serickson017/TAMU-ECEN-404-Team-29-Capstone/Presentations/Automated Greenhouse Status Update 1  (1).pdf

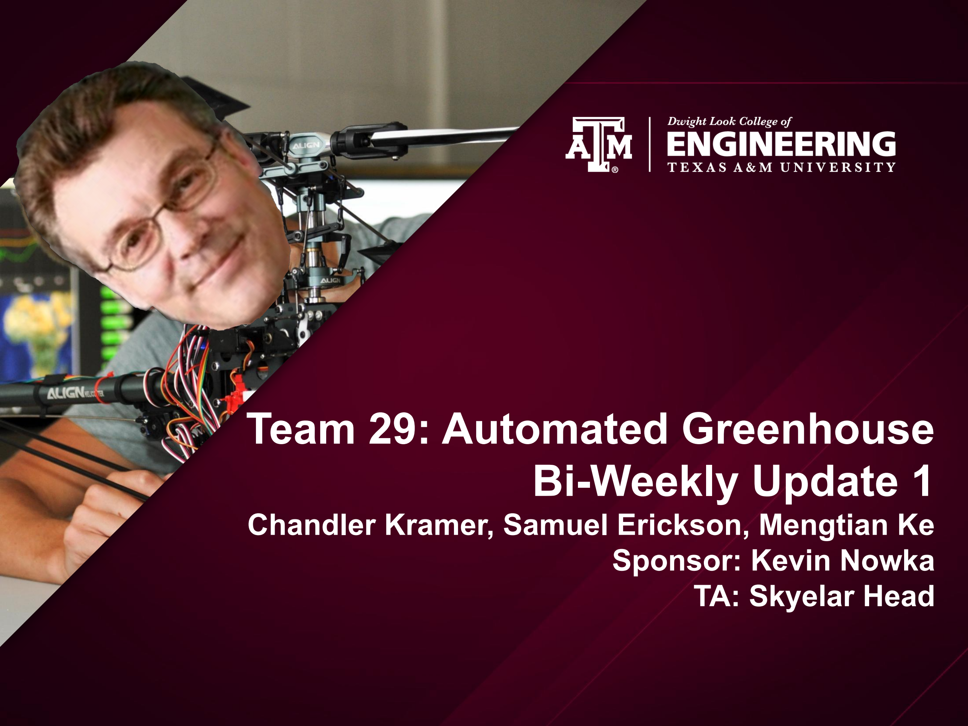
[picture p25: page 1]

# Team 29: Automated Greenhouse Bi-Weekly Update 1

### Chandler Kramer, Samuel Erickson, Mengtian Ke Sponsor: Kevin Nowka TA: Skyelar Head

# Project Summary

## - Traditional gardening, even with a greenhouse, is a very manual process that can be very time consuming and plants are still vulnerable to

the elements.

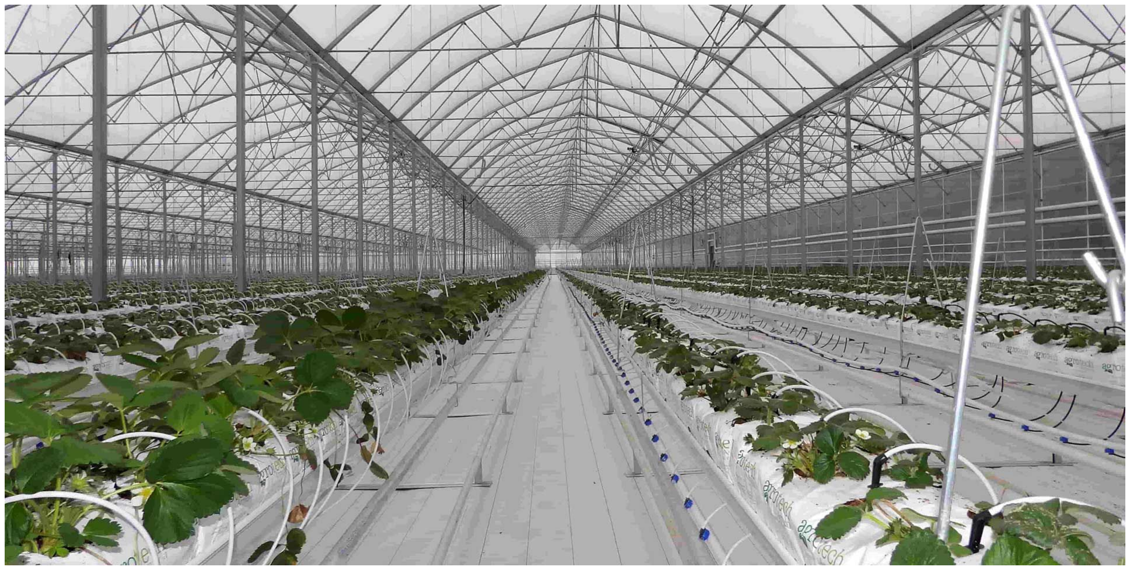
[picture p26: figure]

## - The automatic greenhouse attempts to alleviate this problem by automating water delivery, temperature regulation, and airflow according to remotely set

values by the user.

# Subsystem Overview

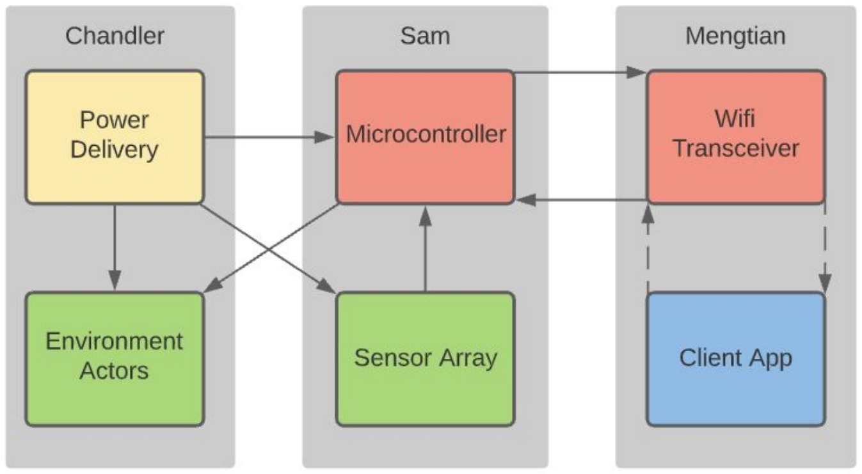
[picture p27: figure]

# Project Changes for 404

- Major change in scale:
- Enclosure increasing in size from 3x3x3ft to 4x4x6ft
- Fan size increase from 140mm to 12in.
- Testing location TBD (campus or Prof. Nowka’s backyard)
- Major change in water supply:
- Moving from reservoir and pump to water spigot
- Water flow will be controlled solely by solenoid valves

# Project Timeline

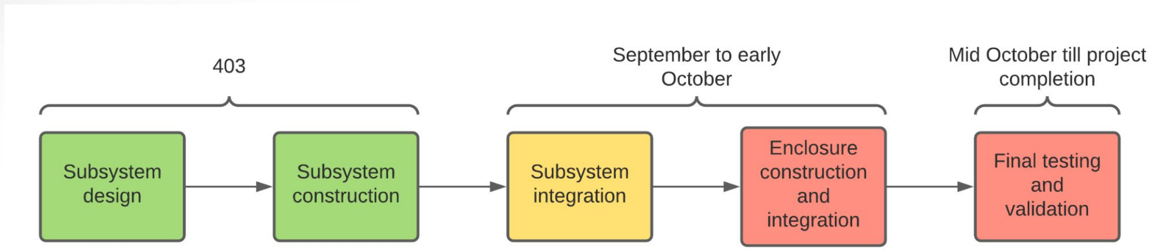
[picture p28: figure]

# Power Subsystem

Owner: Chandler Kramer

Accomplishments since 403 8 hrs of effort | Ongoing progress/problems and plans until the next presentation
- Tested components to ensure functionality - Soldered drives and breakout adapter | - Evaluating and ordering buck converters for Solenoids and MCU - Ordering fans for the updated enclosure

# MCU and Sensor Subsystem

Owner

Accomplishments since 403 8 hrs of effort | Ongoing progress/problems and plans until the next presentation
- Verified mcu and sensor functionality. | - Establish communication with wifi subsystem (I²C) - Drive relay board

# Client Interface Subsystem

Mengtian Ke

Accomplishments since 403 10 hrs of effort | Ongoing progress/problems and plans until the next presentation
- Photon receives data from the web app | - Establish connection with the MCU - Display data to users

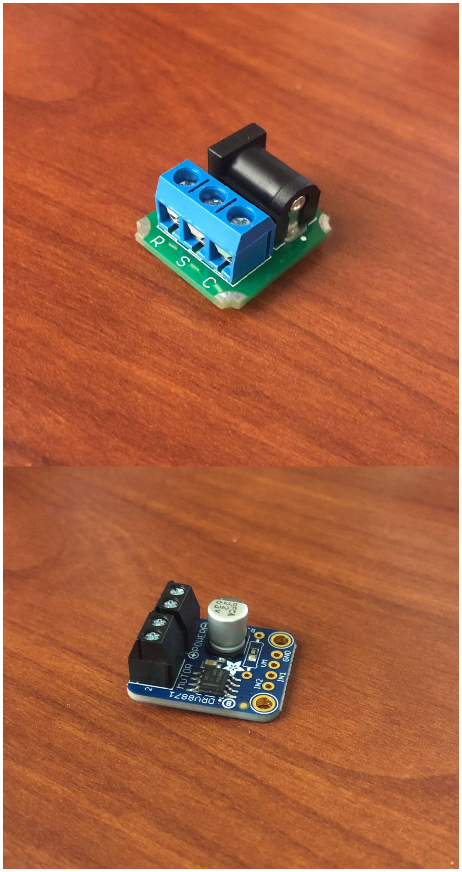
[picture p29: figure]

Changes:
- Irrigation
- Solenoids
- Fans

What needs work:
- Connecting components to MCU
- Permanent configurations

What does work:
- AC power adapter
- Motor Drive

# Power Subsystem

Owner: Chandler Kramer

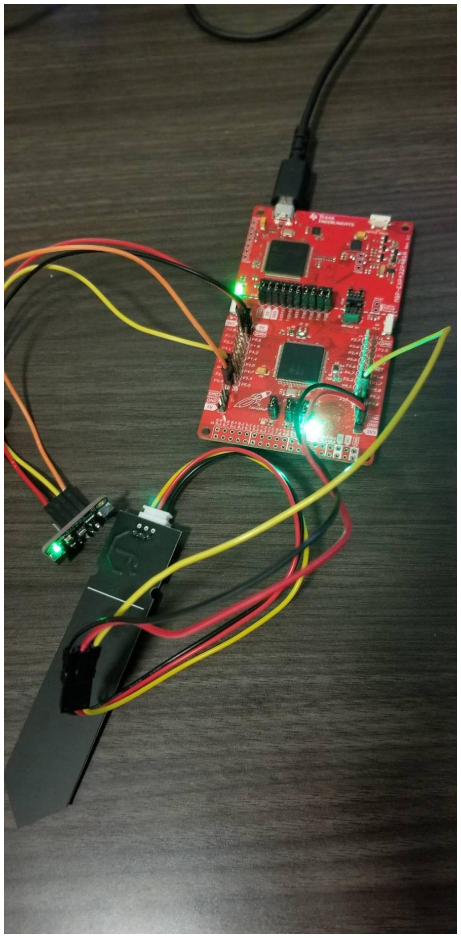
[picture p30: figure]

Changes:
- Will power wifi board instead of discrete power source

What needs work:
- Connecting relay board to MCU
- Establishing communication between MCU and wifi board
- Permanent wiring
- Control algorithm

What does work:
- Sensors

# MCU & Sensor Subsystem

Owner: Samuel Erickson

Changes:
- Photon will get power from MCU to transceiver data

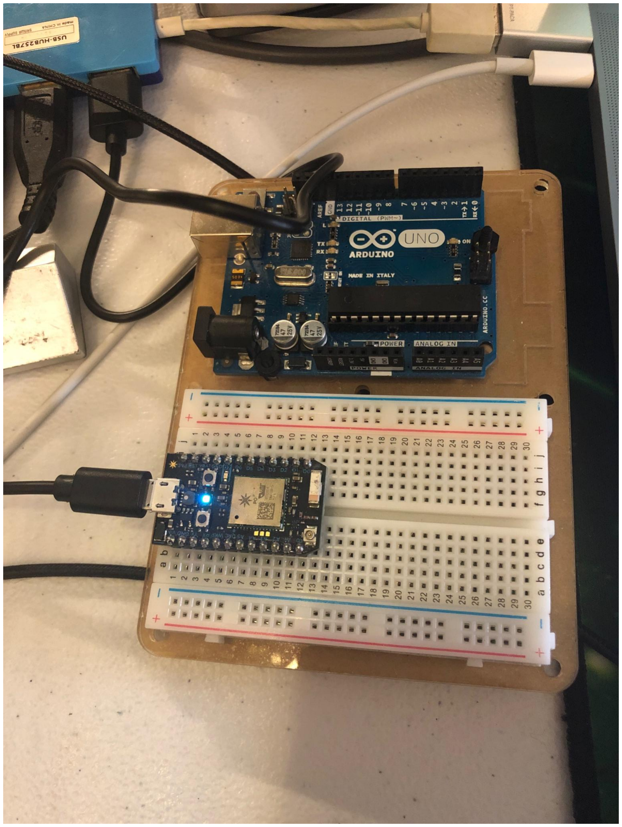
[picture p31: figure]

What needs work:
- Photon transceiver data to the MCU
- Web app displays a live graph

What does work:
- Photon receives data from web app

# Client Interface Subsystem

Owner: Mengtian Ke

# Parts Ordering Status

- Ordered parts
- 2 solenoid valves
- 1 relay board
- 2 12 inch 1800CFM fans
- Still needs to be ordered
- Premade enclosure
- Buck converters

# Execution & Plan

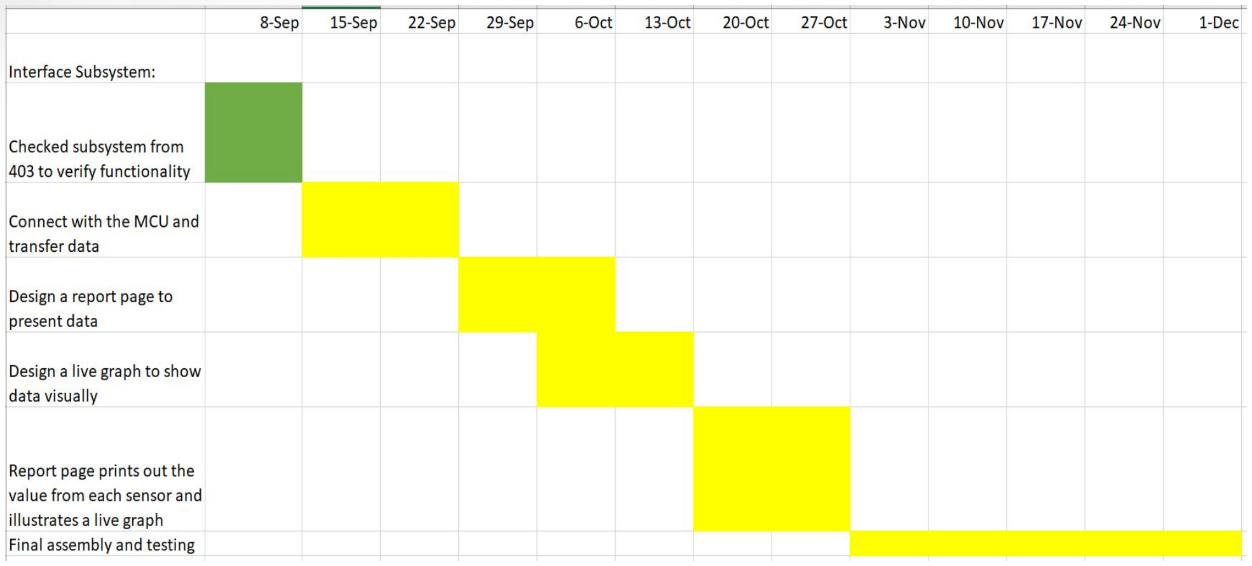
[picture p32: figure]

Execution & Plan cont.

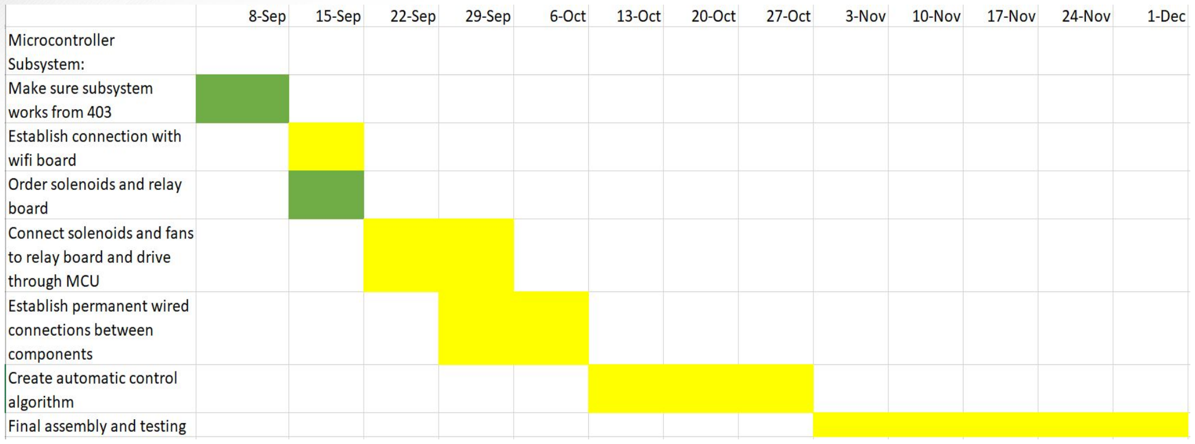
[picture p33: figure]

Execution & Plan cont.

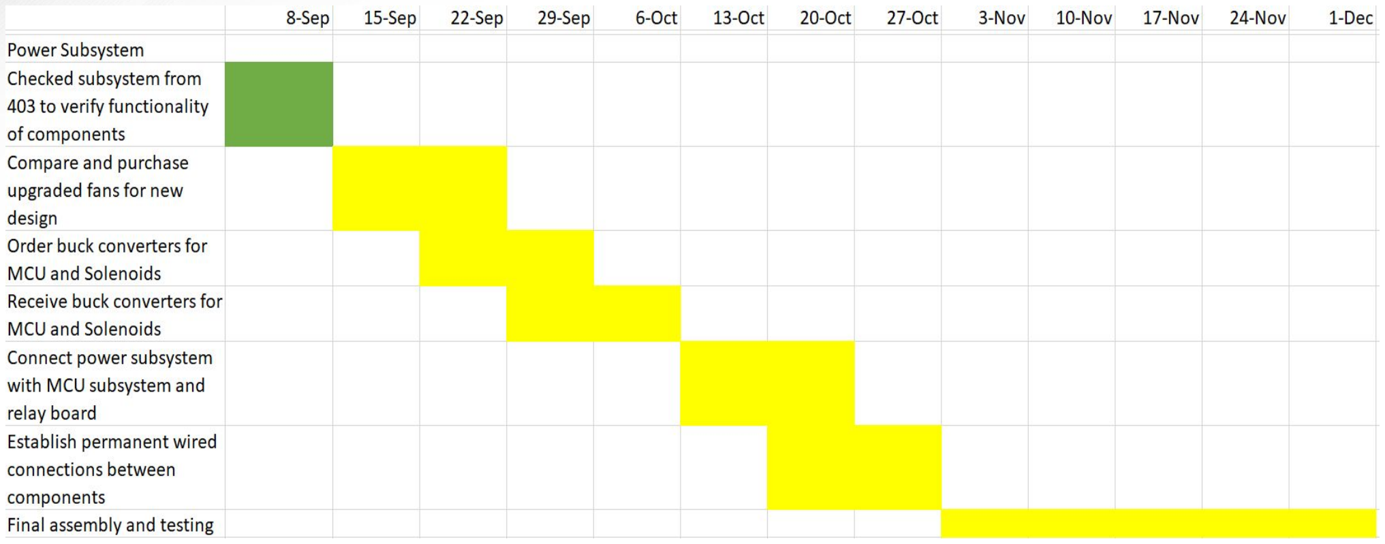
[picture p34: figure]

# Thank you! Any Questions?
