serickson017/TAMU-ECEN-404-Team-29-Capstone/Presentations/Status Update 3  (1).pdf

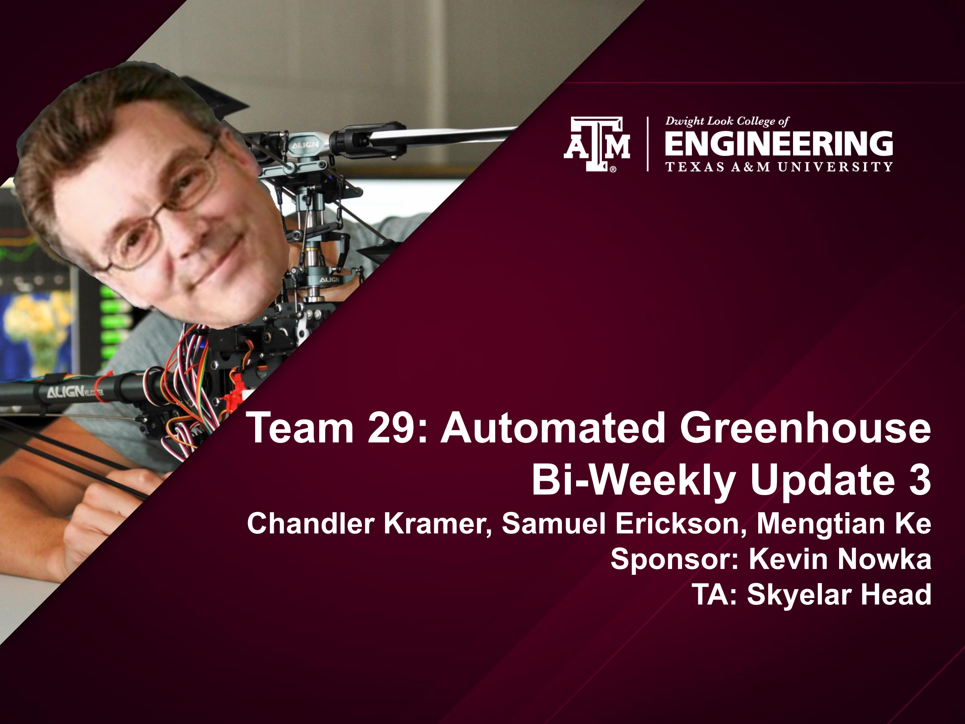
[picture p41: page 1]

# Team 29: Automated Greenhouse Bi-Weekly Update 3

### Chandler Kramer, Samuel Erickson, Mengtian Ke Sponsor: Kevin Nowka TA: Skyelar Head

# Project Summary

## - Traditional gardening, even with a greenhouse, is a very manual process that can be very time consuming and plants are still vulnerable to

the elements.


## - The automatic greenhouse attempts to alleviate this problem by automating water delivery, temperature regulation, and airflow according to remotely set

values by the user.

# Subsystem Overview


# Project Timeline

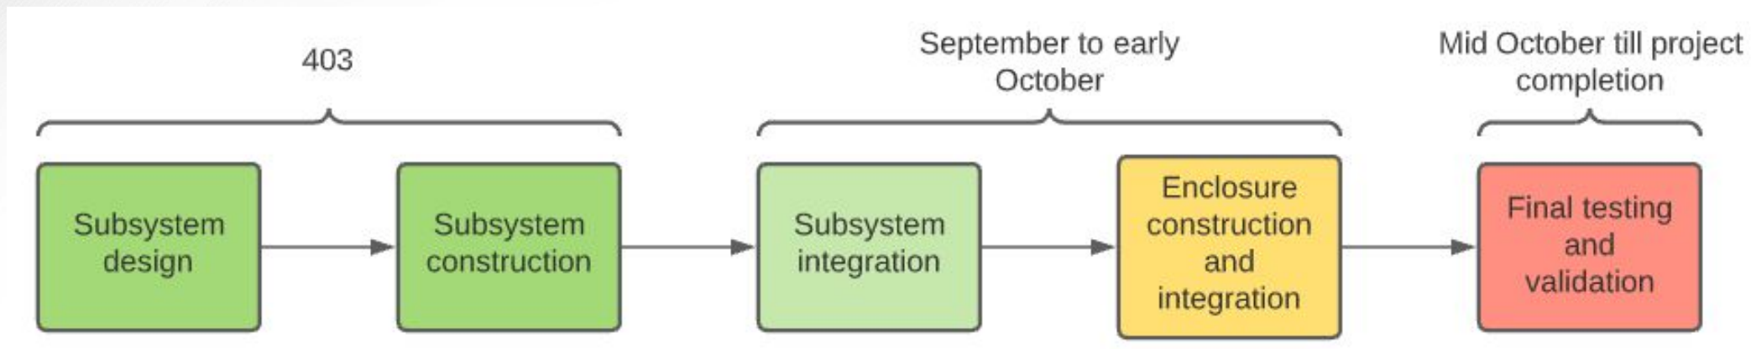
[picture p42: figure]

# Power Subsystem

Accomplishments since last update 12 hrs of effort | Ongoing progress/problems and plans until the next presentation
- Temporary configuration of the buck converter for the MCU | - Integrating the MCU subsystem with the Power Subsystem - Setting up and integrating subsystem with the greenhouse enclosure

Owner: Chandler Kramer

# MCU and Sensor Subsystem

Owner: Samuel Erickson

Accomplishments since last update 7 hrs of effort | Ongoing progress/problems and plans until the next presentation
- Framework of control algorithm created - Sending wifi board sensor-like data to display - Drove solenoid with relay board | - Affix more permanent wiring - Implement control algorithm logic - Integrate with greenhouse enclosure

# Client Interface Subsystem

Owner: Mengtian Ke

Accomplishments since last update 7 hrs of effort | Ongoing progress/problems and plans until the next presentation
- Improved the communication between MCU and Particle board - Display data in the report page | - Communicate with MCU and output the real data - Modify the client interface to be more user friendly

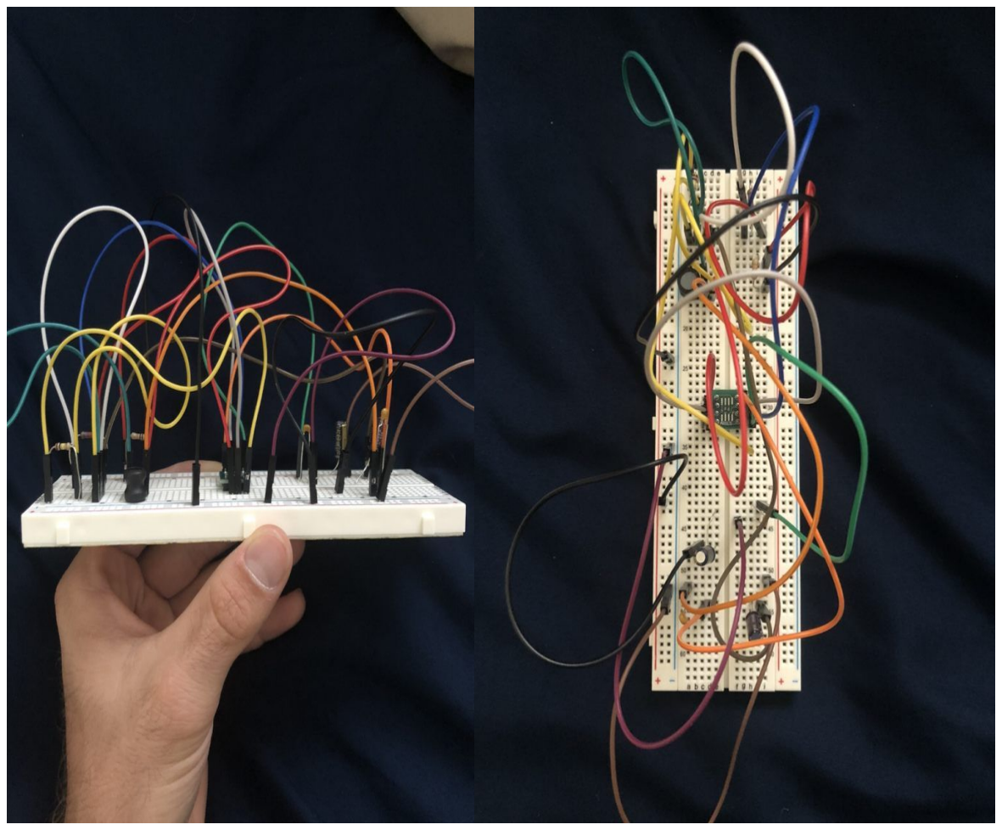
[picture p43: figure]

# - Temporary configuration - USB type A breakout board

# Power Subsystem

# MCU and Sensor Subsystem

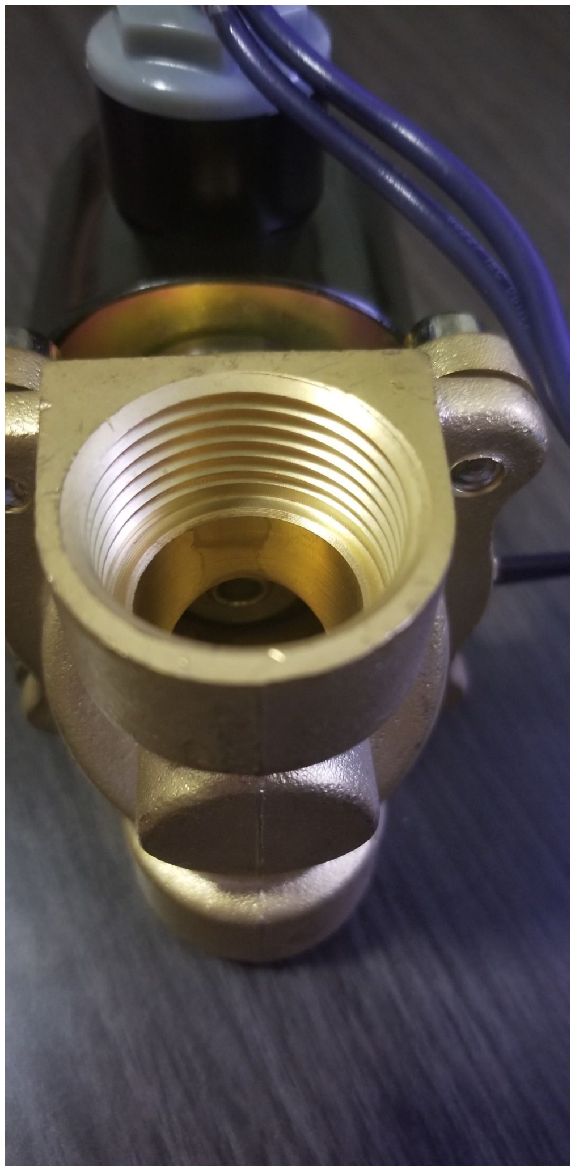
[picture p44: figure]

### - Framework and control functions for control algorithm have

been written.

### - Solenoids driven by planned power source and switched via relay

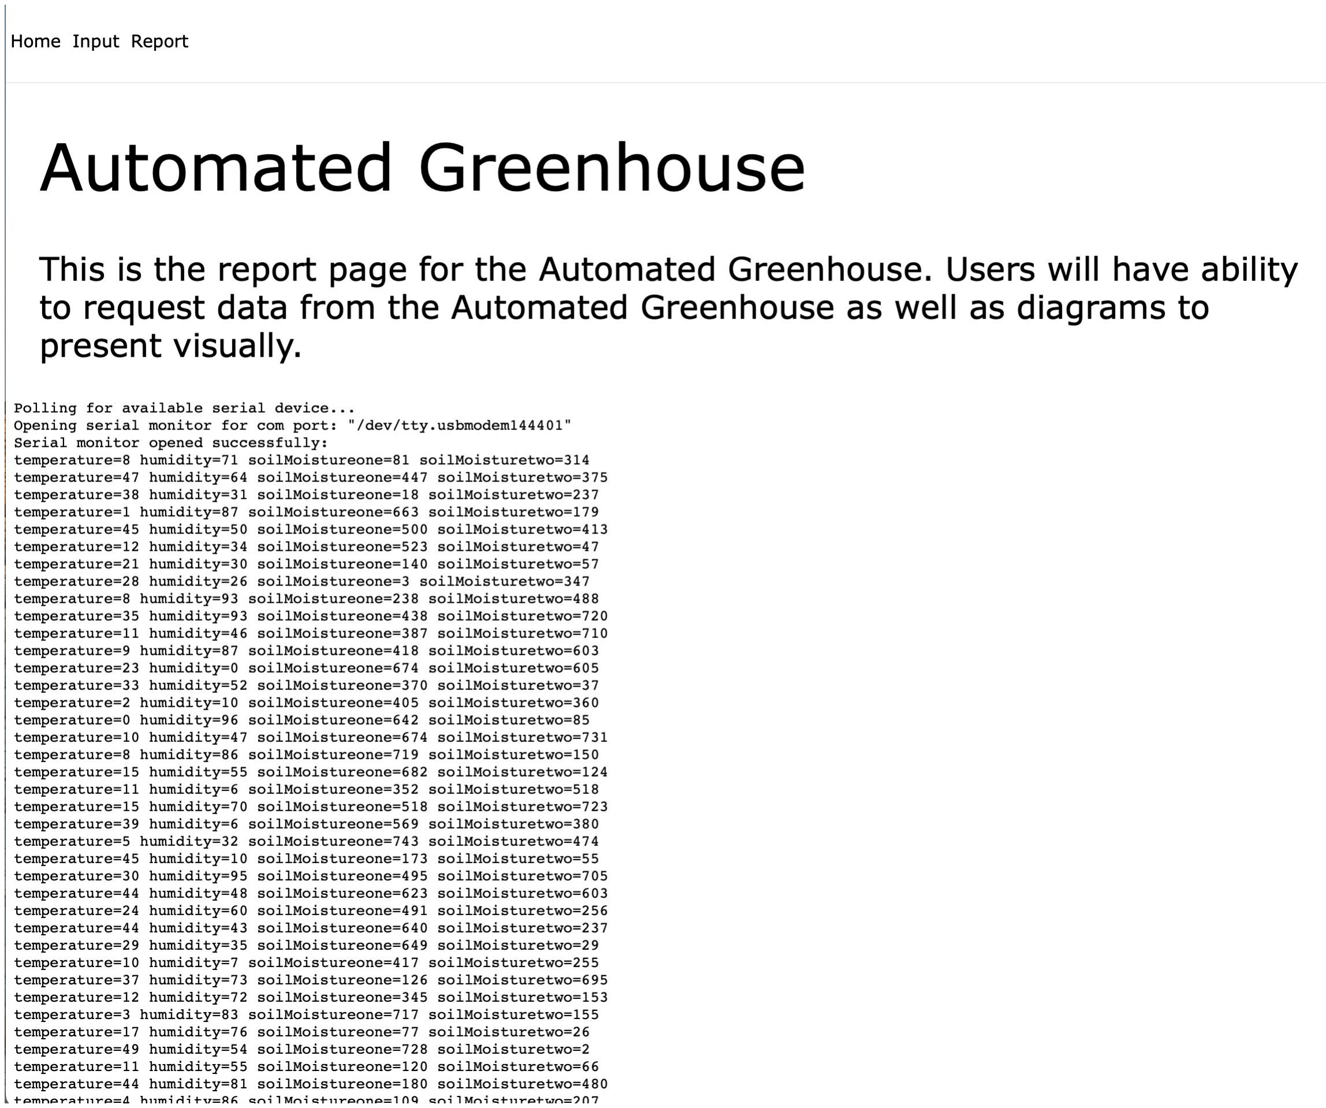
[picture p45: figure]

# - The report page includes four fake data values that generated by rand()

# Client Interface Subsystem

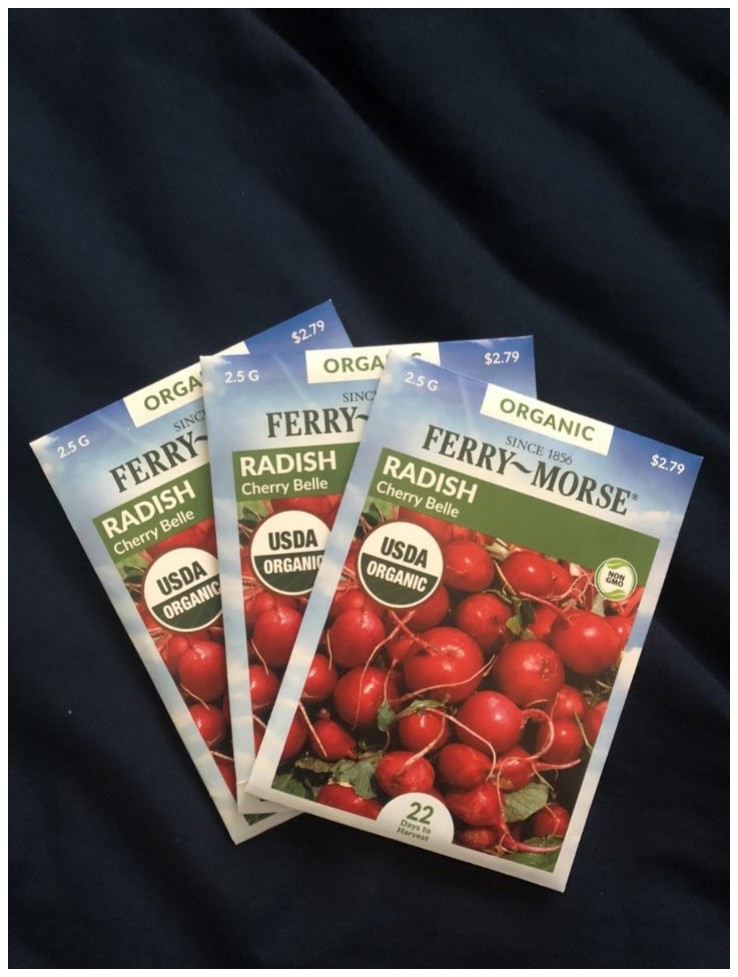
[picture p46: figure]

## - Electronics Box for enclosure - Relay board amperage - Seeds - Additional hardware arriving tomorrow

# Misc. Update

## Execution & Validation Plan

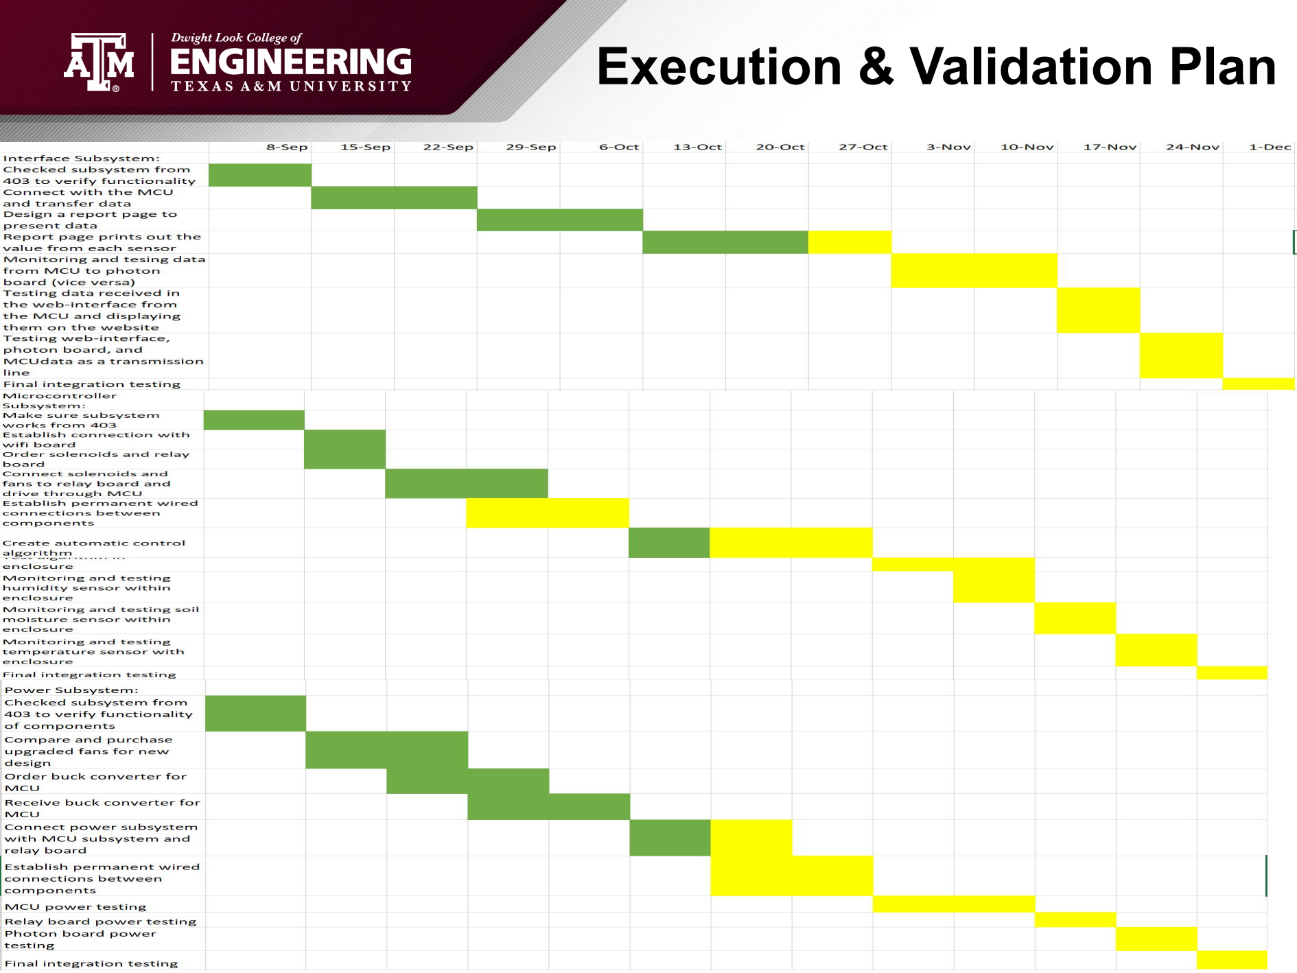
[picture p47: page 12]

# Thank you! Any Questions?
