serickson017/TAMU-ECEN-404-Team-29-Capstone/Presentations/Status Update 5 .pptx (1).pdf

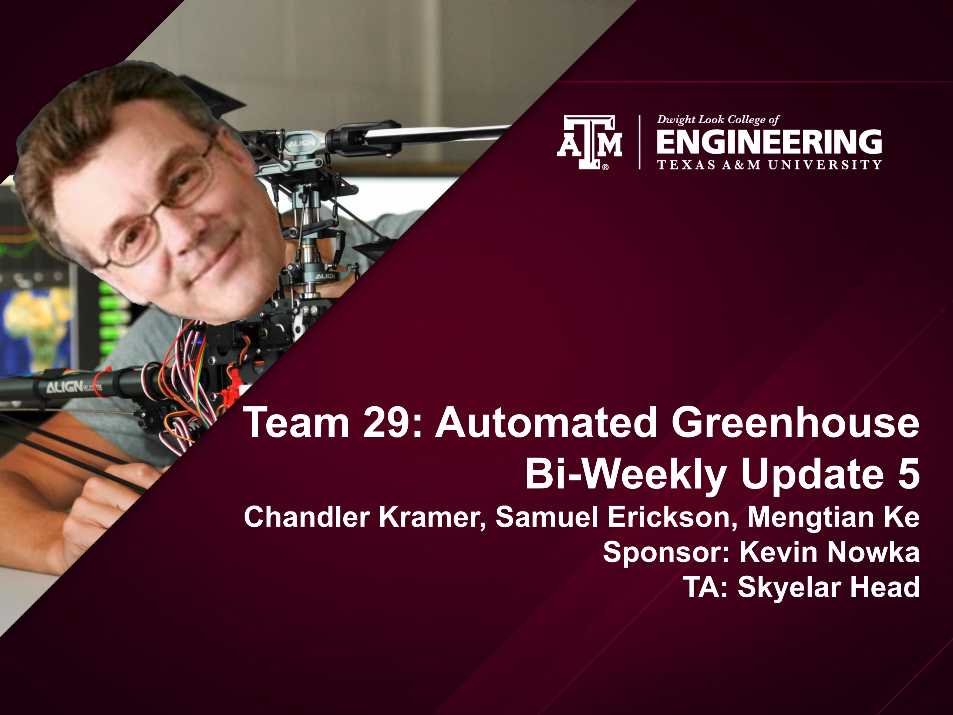
[picture p48: page 1]

# Team 29: Automated Greenhouse Bi-Weekly Update 5

### Chandler Kramer, Samuel Erickson, Mengtian Ke Sponsor: Kevin Nowka TA: Skyelar Head

# Project Summary

## - Traditional gardening, even with a greenhouse, is a very manual process that can be very time consuming and plants are still vulnerable to

the elements.


## - The automatic greenhouse attempts to alleviate this problem by automating water delivery, temperature regulation, and airflow according to remotely set

values by the user.

# Integrated System Diagram

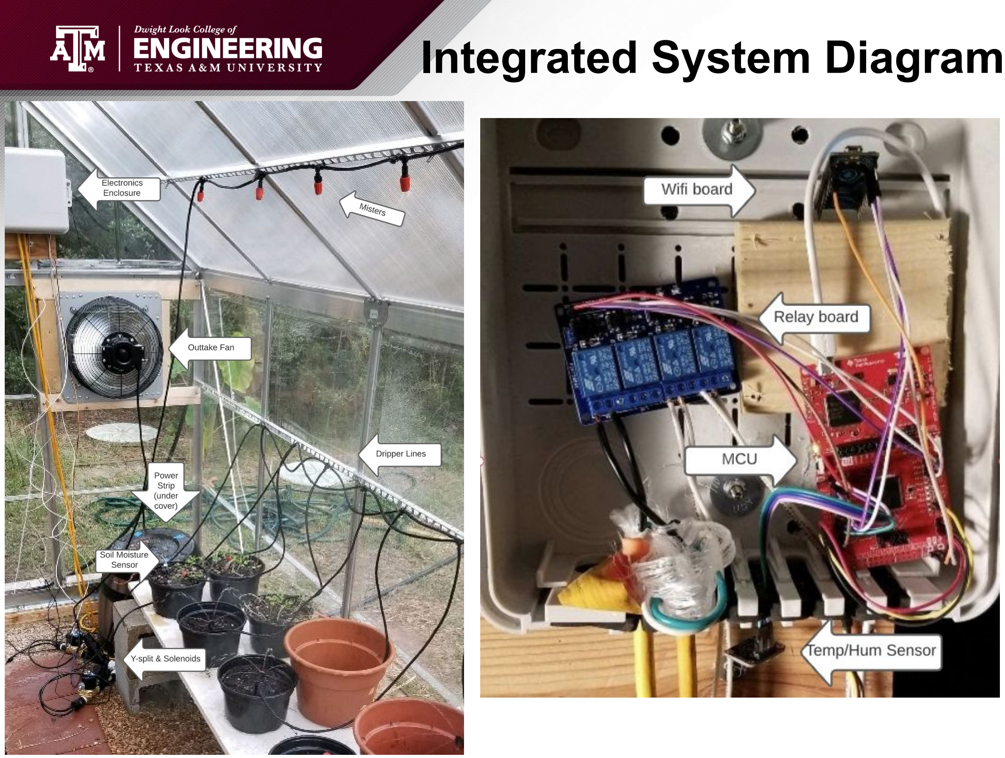
[picture p49: page 3]

# Project Timeline

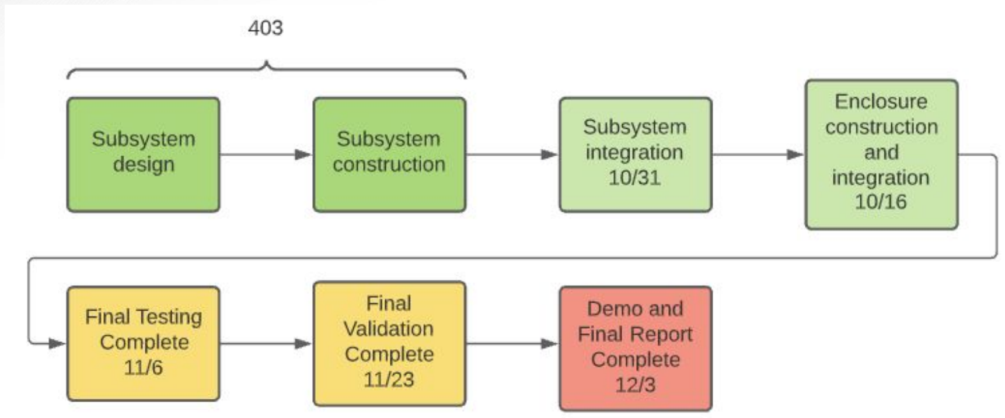
[picture p50: figure]

# Power Subsystem

Accomplishments since last update 18 hrs of effort | Ongoing progress/problems and plans until the next presentation
- New BC - Ordered PCB Components - Began PCB Design - Perf Board - Perf Board Components | - Finalize PCB Design and have it sent out - Construct Prototype on Perf Board - Test Bench Prototype

Owner: Chandler Kramer

# MCU and Sensor Subsystems

Owner: Samuel Erickson

Accomplishments since last update 9 hrs of effort

Ongoing progress/problems and plans until the next presentation
- Tested humidity and soil moisture control algorithm, collected data on current
performance
- Validated wifi connectivity and data collection in live
environment
- Add improvements to algorithm based on test data
- Test updated algorithm and validate in live environment

# Client Interface Subsystem

Owner: Mengtian Ke

Accomplishments since last update 10 hrs of effort

Ongoing progress/problems and plans until the next presentation
- Client Interface sends out data to temperature, humidity and soil moisture sensor and
receive current data every two seconds.
- Implemented features in the Client Interface
- Display data trading over time
- Summarize data over a period of time

# Power Subsystem

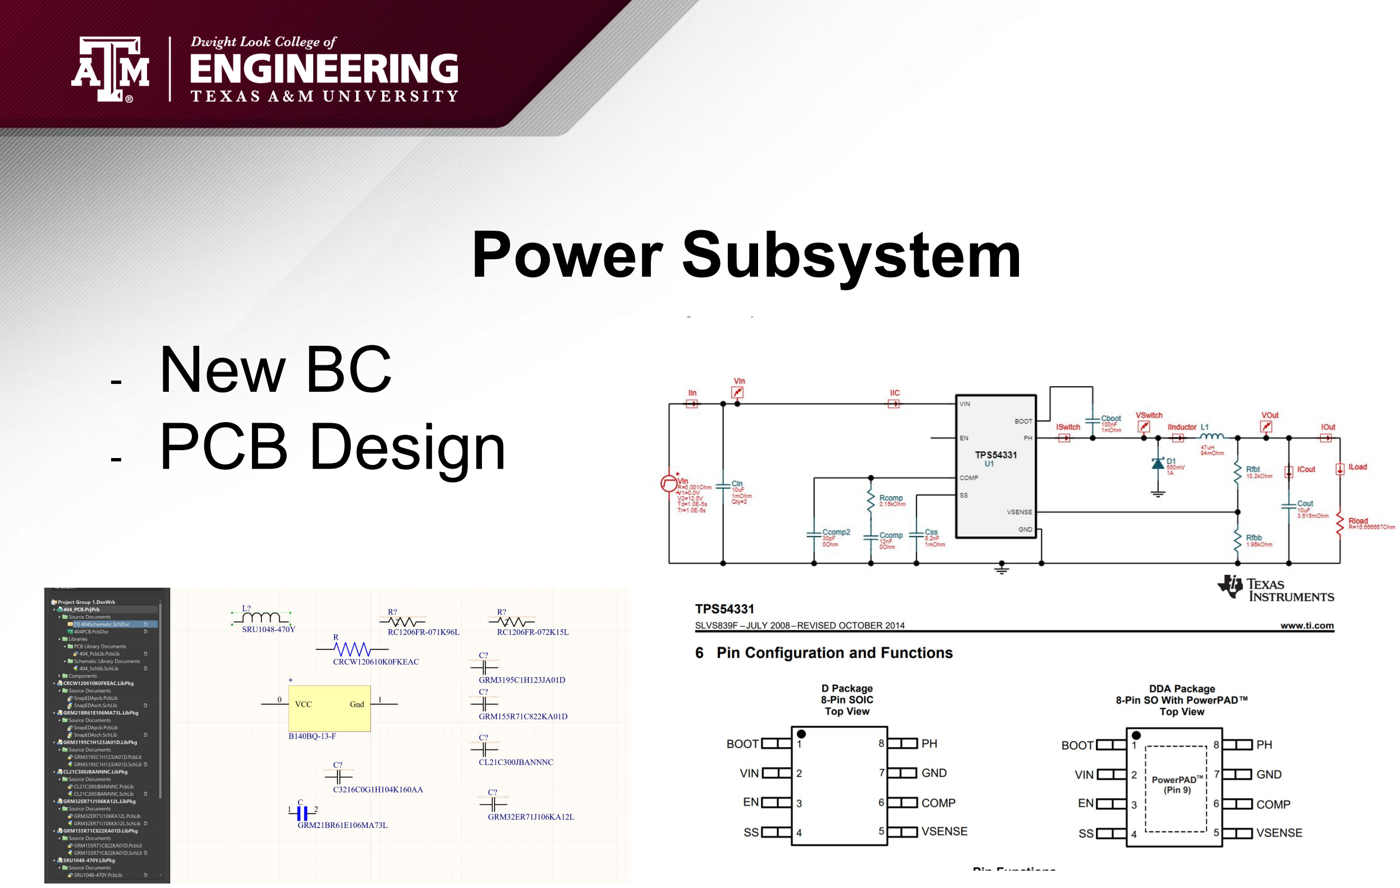
[picture p51: page 8]

# - New BC - PCB Design

### - Data collection on current performance of humidity and soil moisture control

# MCU and Sensors

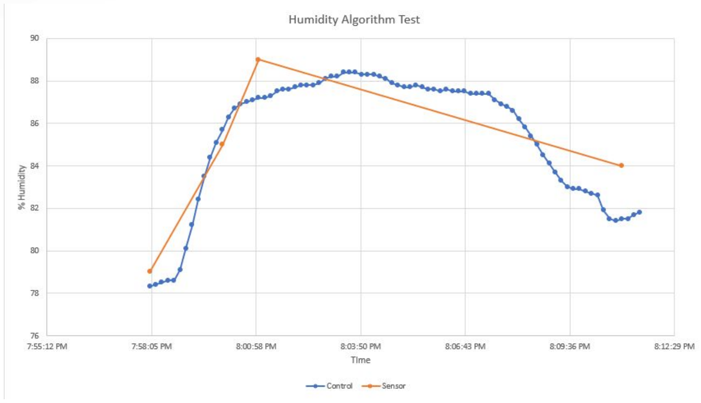
[picture p52: figure]

- Current humidity
control algorithm
slightly overshoots
humidity
- Current irrigation
solution lets water
reach the bottom of
pot in ~40 seconds

# Client Interface Subsystem

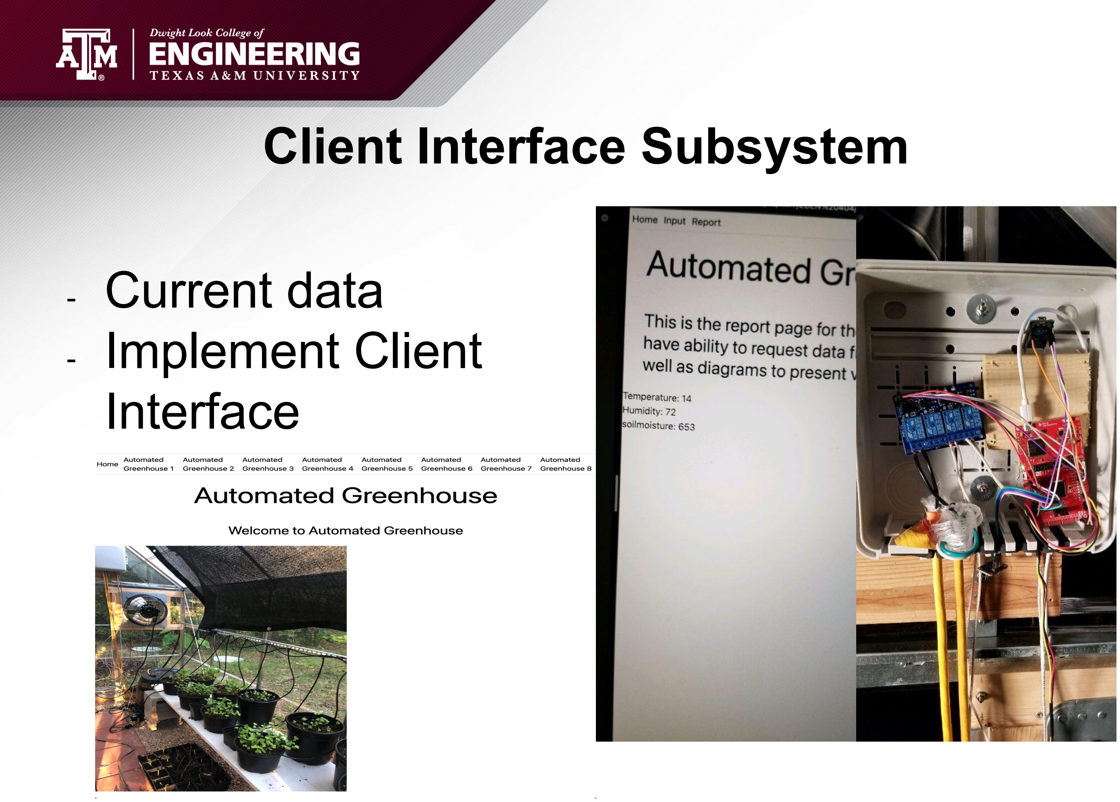
[picture p53: page 10]

# - Current data - Implement Client Interface

## Execution & Validation Plan

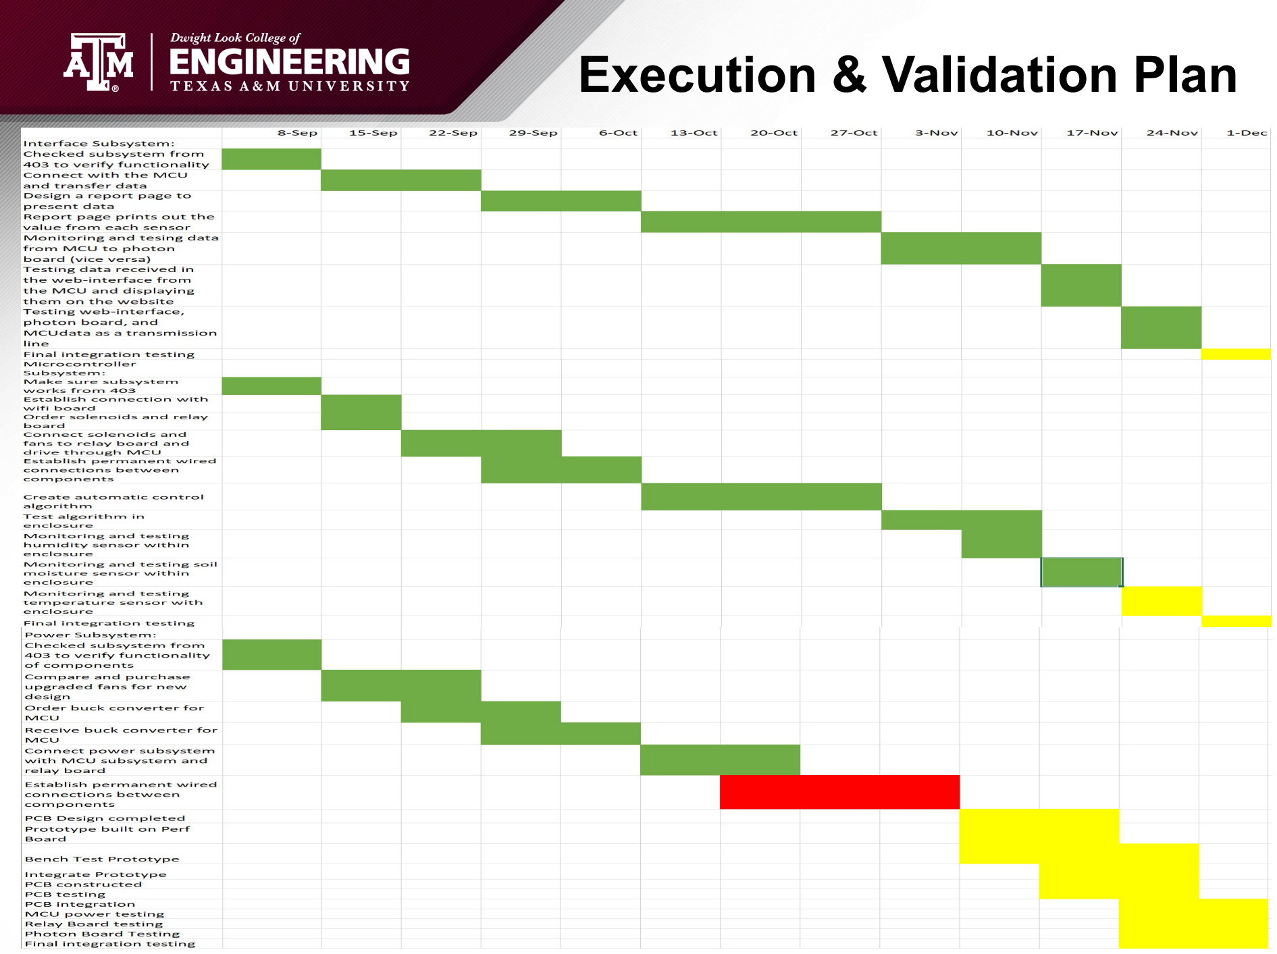
[picture p54: page 11]

# Thank you! Any Questions?
