serickson017/TAMU-ECEN-404-Team-29-Capstone/Power Subsystem/New Buck Converter.PNG

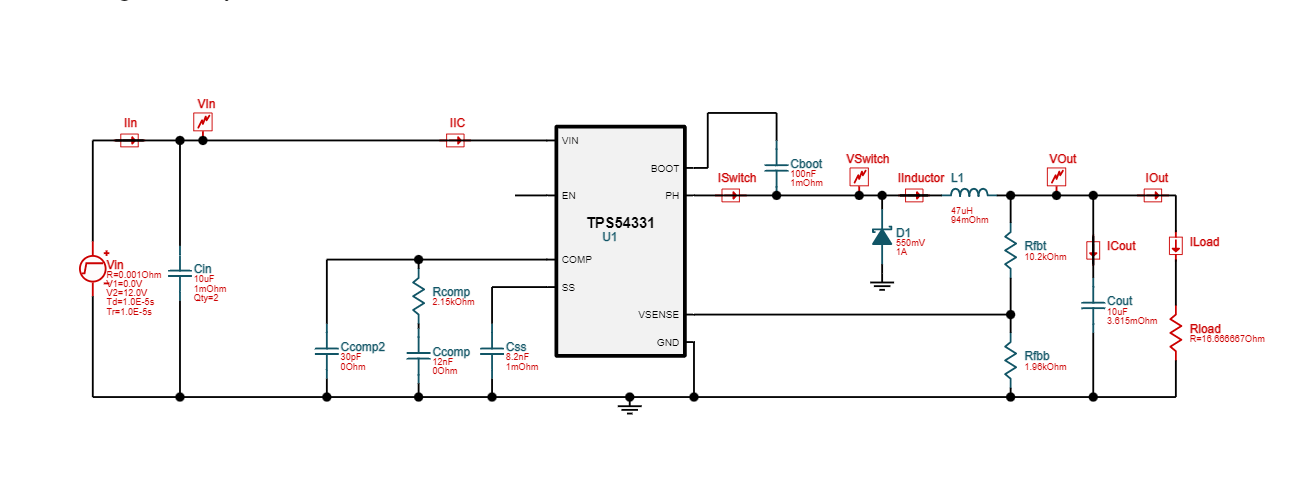
Power Subsystem/New Buck Converter.PNG
