serickson017/TAMU-ECEN-404-Team-29-Capstone/Power Subsystem/PCB Components.xlsx

Capacitors: |  | Resistors: |  | Inductor: |  | Diode:
Cboot: 100 nF | https://www.digikey.com/en/products/detail/samsung-electro-mechanics/CL31C104JAHNNWE/5961272 | Rcomp: 2.15k | https://www.digikey.com/en/products/detail/te-connectivity-passive-product/RQ73C2B2K15BTD/9479697 | L1: 47uH | https://www.digikey.com/en/products/detail/taiyo-yuden/CBC3225T470KR/2763321 | D1
Cin: 10uF x2 | https://www.digikey.com/en/products/detail/samsung-electro-mechanics/CL31A106KOHNNNE/3886795 | Rfbt: 10.2k | https://www.digikey.com/en/products/detail/te-connectivity-passive-product/RQ73C2B10K2BTD/9480901
Ccomp: 12nF | https://www.digikey.com/en/products/detail/kemet/C0805C123G4HACAUTO/7958700 | Rfbb: 1.96k | https://www.digikey.com/en/products/detail/te-connectivity-passive-product/RQ73C2B1K96BTD/9479693
Css: 8.2nf | https://www.digikey.com/en/products/detail/kyocera-avx/12063A822JAT2A/563613
Cout: 10uF | https://www.digikey.com/en/products/detail/samsung-electro-mechanics/CL31A106KOHNNNE/3886795
Ccomp2: 30pF | https://www.digikey.com/en/products/detail/kyocera-avx/08055A300JAT2A/1602540
